Vymarus/34346-bikelight/KiCad/BikeLight/BikeLight.png

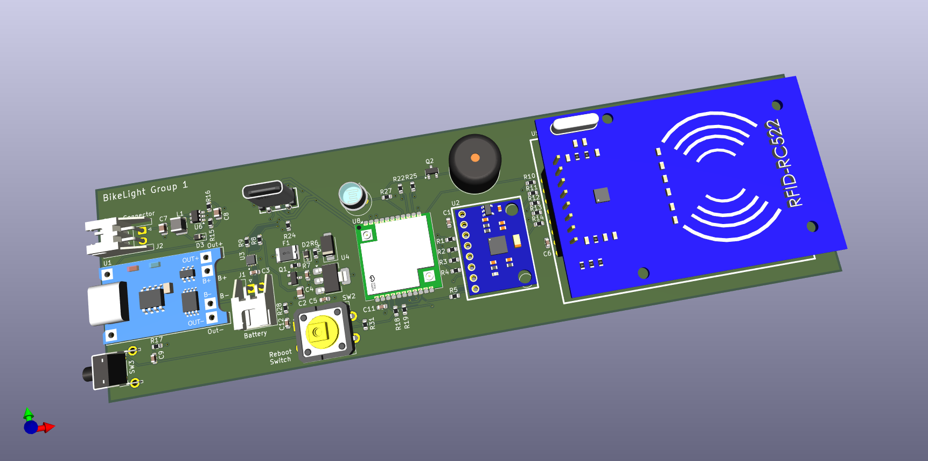
KiCad/BikeLight/BikeLight.png
