Vymarus/34346-bikelight/FreeCad/RFID_RC522-RFID.step

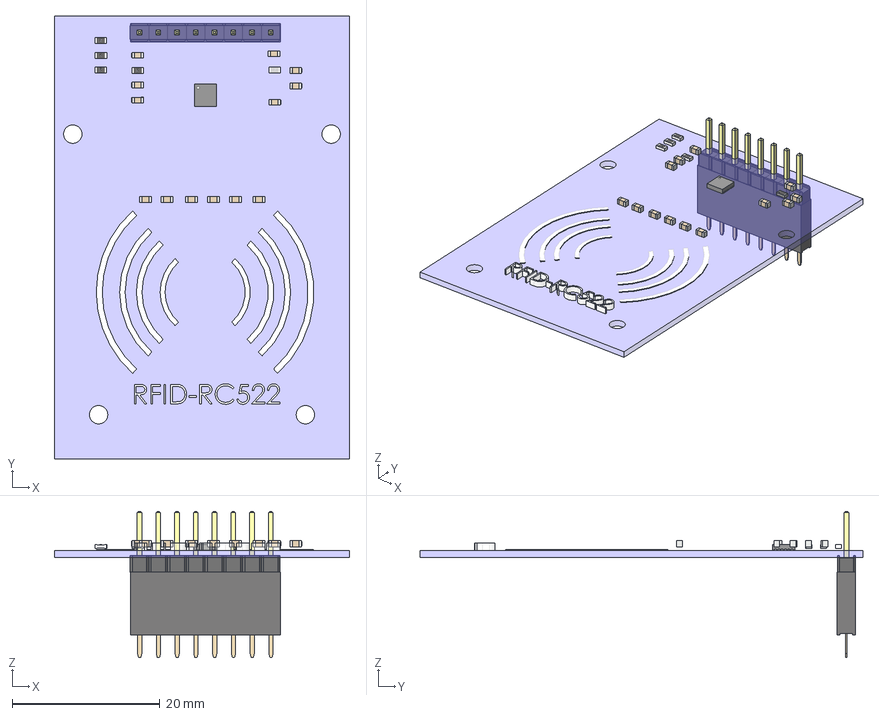
[picture p2: CAD file, 2025-05-14]
FreeCad/RFID_RC522-RFID.step
40.0 x 60.0 x 19.8 mm
User Library-S-PWSON-N12
User Library-S-PWSON-N013
User Library-S-PWSON-N014
User Library-S-PWSON-N015
User Library-S-PWSON-N016
User Library-S-PWSON-N017
User Library-S-PWSON-N018
User Library-S-PWSON-N019
User Library-S-PWSON-N020
User Library-S-PWSON-N021
User Library-S-PWSON-N022
User Library-S-PWSON-N023
User Library-S-PWSON-N024
User Library-S-PWSON-N025
User Library-Header_Male_8Pin
User Library-Header_Male_8Pin001
User Library-Header_Male_8Pin002
User Library-Header_Male_8Pin003
User Library-Header_Male_8Pin004
User Library-Header_Male_8Pin005
User Library-Header_Male_8Pin006
User Library-Header_Male_8Pin007
User Library-Header_Male_8Pin008
User Library-Header_Male_8Pin009
User Library-Header_Male_8Pin010
User Library-Header_Male_8Pin011
User Library-Header_Male_8Pin012
User Library-Header_Male_8Pin013
User Library-Header_Male_8Pin014
User Library-Header_Male_8Pin015
User Library-SMD Ceramic Capacitors_0603 (1608)_CH
User Library-SMD Ceramic Capacitors_0603 (1608)_CH001
User Library-SMD Ceramic Capacitors_0603 (1608)_CH002
User Library-SMD Ceramic Capacitors_0603 (1608)_CH004
User Library-SMD Ceramic Capacitors_0603 (1608)_CH005
User Library-SMD Ceramic Capacitors_0603 (1608)_CH006
User Library-SMD Ceramic Capacitors_0603 (1608)_CH008
User Library-SMD Ceramic Capacitors_0603 (1608)_CH009
User Library-SMD Ceramic Capacitors_0603 (1608)_CH010
User Library-SMD Ceramic Capacitors_0603 (1608)_CH012
User Library-SMD Ceramic Capacitors_0603 (1608)_CH013
User Library-SMD Ceramic Capacitors_0603 (1608)_CH014
User Library-SMD Ceramic Capacitors_0603 (1608)_CH016
User Library-SMD Ceramic Capacitors_0603 (1608)_CH017
User Library-SMD Ceramic Capacitors_0603 (1608)_CH018
User Library-SMD Ceramic Capacitors_0603 (1608)_CH020
User Library-SMD Ceramic Capacitors_0603 (1608)_CH021
User Library-SMD Ceramic Capacitors_0603 (1608)_CH022
User Library-SMD Ceramic Capacitors_0603 (1608)_CH024
User Library-SMD Ceramic Capacitors_0603 (1608)_CH025
User Library-SMD Ceramic Capacitors_0603 (1608)_CH026
User Library-SMD Ceramic Capacitors_0603 (1608)_CH028
User Library-SMD Ceramic Capacitors_0603 (1608)_CH029
User Library-SMD Ceramic Capacitors_0603 (1608)_CH030
User Library-SMD Ceramic Capacitors_0603 (1608)_CH032
User Library-SMD Ceramic Capacitors_0603 (1608)_CH033
User Library-SMD Ceramic Capacitors_0603 (1608)_CH034
User Library-SMD Ceramic Capacitors_0603 (1608)_CH036
User Library-SMD Ceramic Capacitors_0603 (1608)_CH037
User Library-SMD Ceramic Capacitors_0603 (1608)_CH038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
