Vymarus/34346-bikelight/KiCad/BikeLight/BikeLight3D/RFID_RC522.step

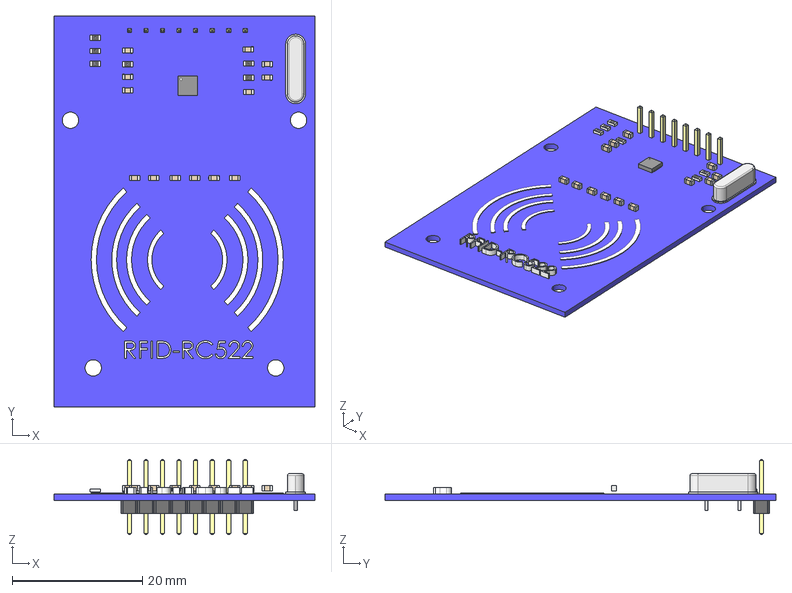
[picture p4: CAD file, 2025-04-30]
KiCad/BikeLight/BikeLight3D/RFID_RC522.step
40.0 x 60.0 x 11.5 mm
User Library-S-PWSON-N12
User Library-S-PWSON-N013
User Library-S-PWSON-N014
User Library-S-PWSON-N015
User Library-S-PWSON-N016
User Library-S-PWSON-N017
User Library-S-PWSON-N018
User Library-S-PWSON-N019
User Library-S-PWSON-N020
User Library-S-PWSON-N021
User Library-S-PWSON-N022
User Library-S-PWSON-N023
User Library-S-PWSON-N024
User Library-S-PWSON-N025
User Library-Header_Male_8Pin
User Library-Header_Male_8Pin001
User Library-Header_Male_8Pin002
User Library-Header_Male_8Pin003
User Library-Header_Male_8Pin004
User Library-Header_Male_8Pin005
User Library-Header_Male_8Pin006
User Library-Header_Male_8Pin007
User Library-Header_Male_8Pin008
User Library-Header_Male_8Pin009
User Library-Header_Male_8Pin010
User Library-Header_Male_8Pin011
User Library-Header_Male_8Pin012
User Library-Header_Male_8Pin013
User Library-Header_Male_8Pin014
User Library-Header_Male_8Pin015
User Library-SMD Ceramic Capacitors_0603 (1608)_CH x 13
User Library-SMD Ceramic Capacitors_0603 (1608)_CH001 x 13
User Library-SMD Ceramic Capacitors_0603 (1608)_CH002 x 13
