Vymarus/34346-bikelight/KiCad/BikeLight/BikeLight3D/PCB_TP_4056.stp

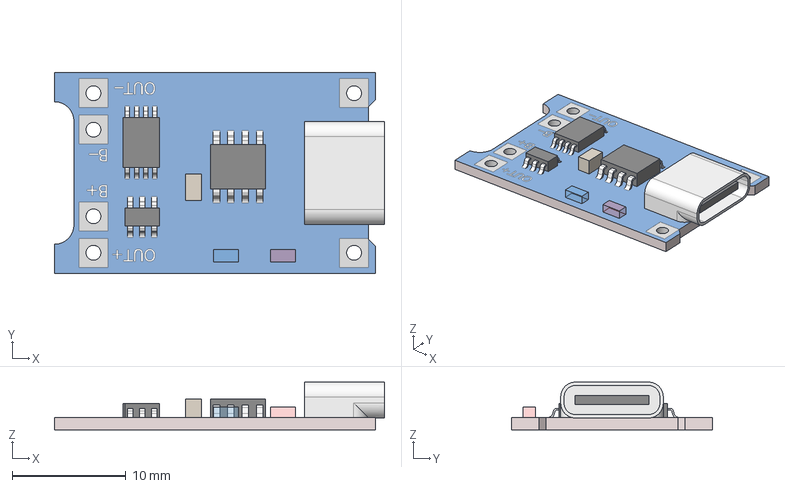
[picture p6: CAD file, 2025-04-24]
KiCad/BikeLight/BikeLight3D/PCB_TP_4056.stp
28.9 x 17.6 x 4.20 mm
