Vymarus/34346-bikelight/KiCad/BikeLight/BikeLight3D/GY-521.step

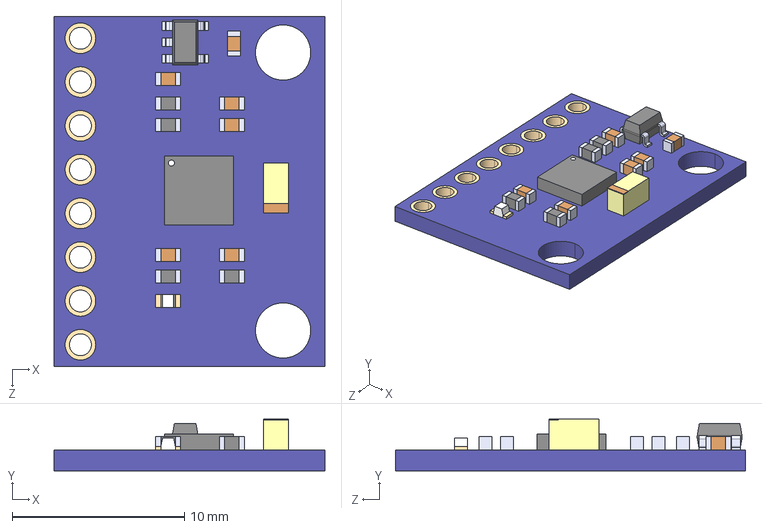
[picture p7: CAD file, 2025-04-24]
KiCad/BikeLight/BikeLight3D/GY-521.step
15.7 x 3.00 x 20.3 mm
