Vymarus/34346-bikelight/KiCad/BikeLight/BikeLight3D/MAX17048G_T10.step

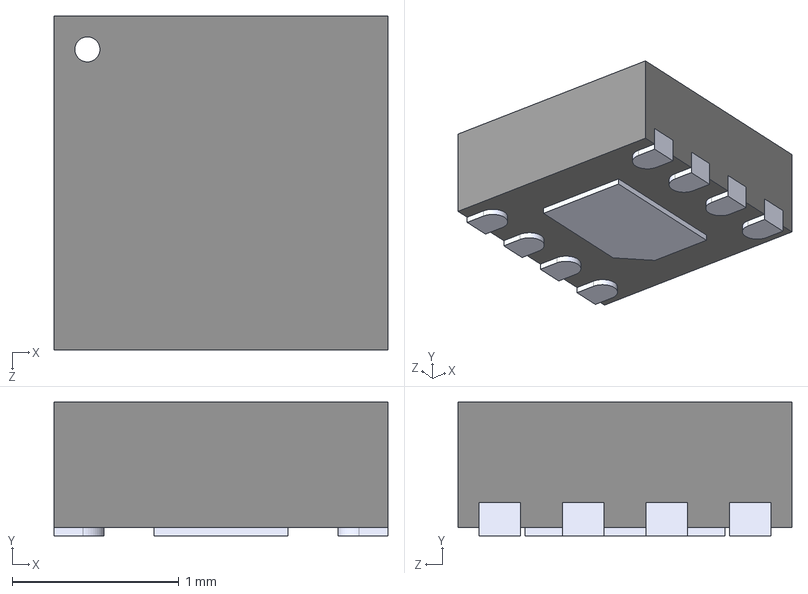
[picture p8: CAD file, 2025-04-24]
KiCad/BikeLight/BikeLight3D/MAX17048G_T10.step
2.00 x 0.8 x 2.00 mm
