Vymarus/34346-bikelight/(list of files, cad)

Other CAD files:
FreeCad/RFID_RC522.FCStd
