Vymarus/34346-bikelight/KiCad/BikeLight/BikeLight.kicad_pcb

## KiCad design KiCad/BikeLight/BikeLight.kicad_pcb (2025-05-24)

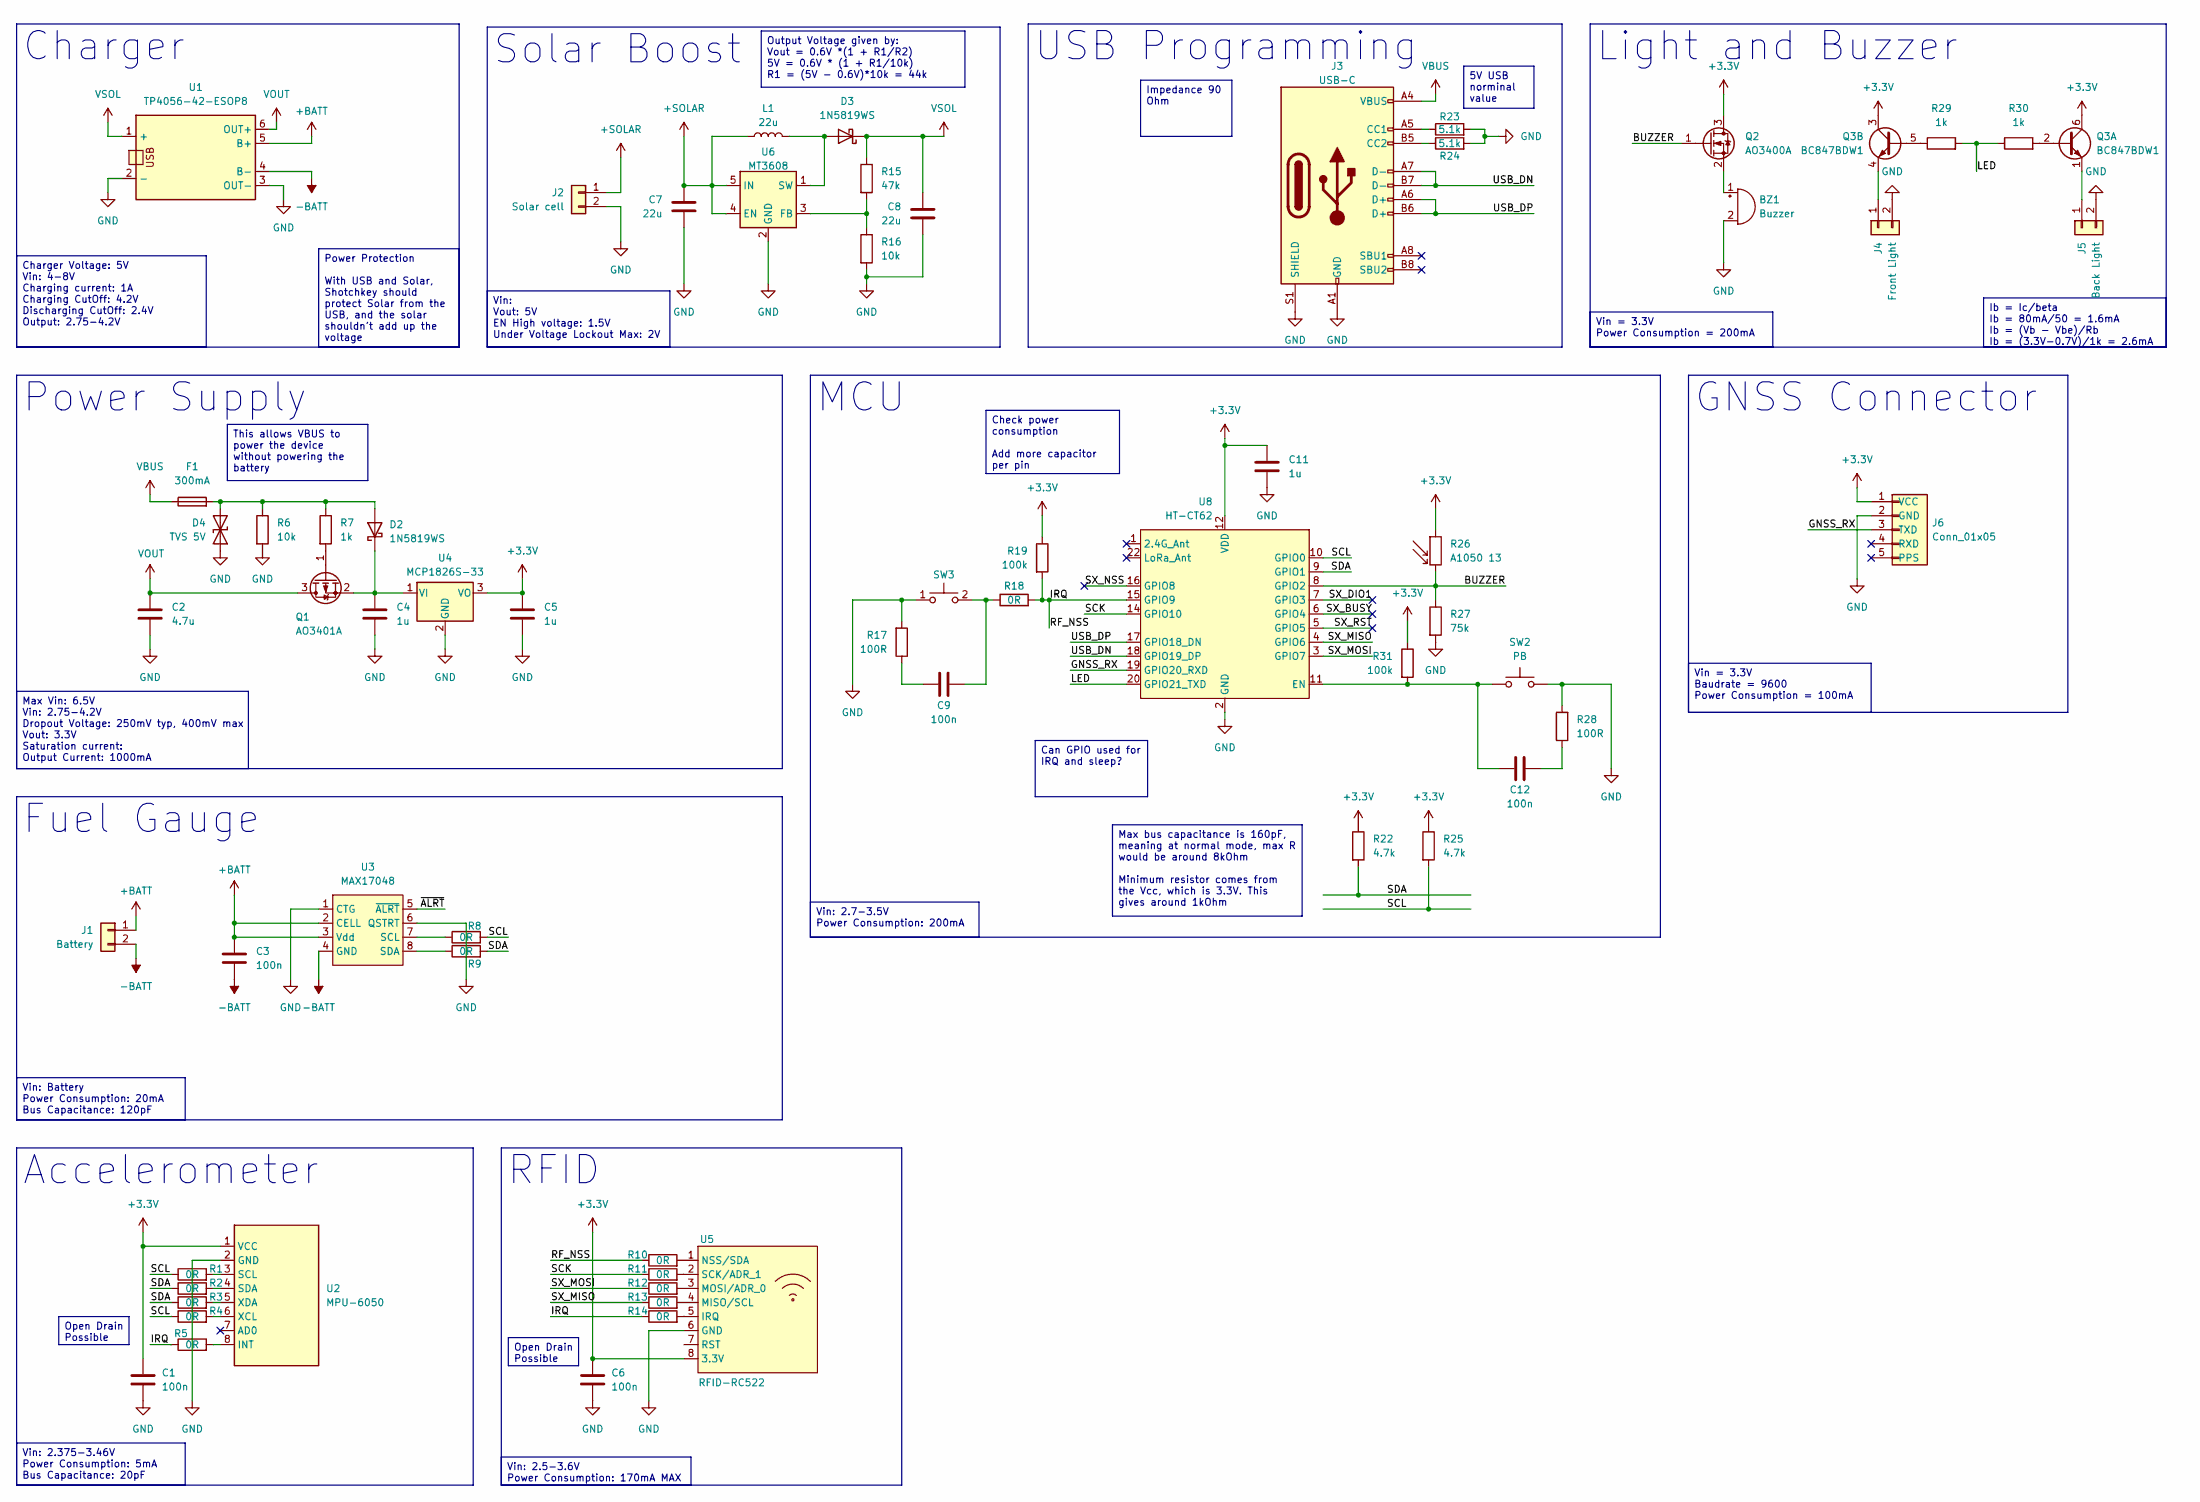
[picture p9: schematic BikeLight.kicad_sch, BeamBuddy]

Parts:
BZ1: TMB12A03; Buzzer_12x9.5RM7.6; MPN TMB12A03
C1, C3, C6, C9, C12: 100n_0603_TCC0603X7R104K500CT; C_0603_1608Metric; Tolerance 10%; Rating 50V; MPN TCC0603X7R104K500CT
C2: 4.7u_0805_CL21A475KAQNNNE; C_0805_2012Metric; Rating 25V; Tolerance 10%; MPN CL21A475KAQNNNE
C4: 1u_0603_CL10A105KA8NNNC; C_0603_1608Metric; MPN CL10A105KA8NNNC
C5, C11: 1u_0603_UMK107BJ105KA-T; C_0603_1608Metric; MPN UMK107BJ105KA-T
C7, C8: 22u_0805_CL21A226MAQNNNE; C_0805_2012Metric; Rating 10V; Tolerance 20%; MPN CL21A226MAQNNNE
D2, D3: 1N5819WS; D_SOD-323; MPN 1N5819WS
D4: SMAJ5.0CA/TR13_NONAME; D_SMA; MPN SMAJ5.0CA/TR13
F1: MF-MSMF010-2; Fuse_1812_4532Metric; MPN MF-MSMF010-2
J1, J2, J4, J5: Conn-01x02_P2.5mm_S2B-XH-A-BK(LF)(SN); JST_XH_S2B-XH-A_1x02_P2.50mm_Horizontal; MPN S2B-XH-A-BK(LF)(SN)
J3: GT-USB-7051A; USB-C-SMD_GT-USB-7051A; MPN GT-USB-7051A
J6: Conn_01x05; PinHeader_1x05_P2.54mm_Horizontal; LCSC C492413
L1: 22u_620mA_1210_CBC3225T220KR; L_1210_3225Metric; Rating 620mA; MPN CBC3225T220KR
Q1: AO3401A; SOT-23; MPN AO3401A
Q2: AO3400A; SOT-23; MPN AO3400A
Q3: BC847BDW1; SOT-363_SC-70-6
R1, R2, R3, R4, R5, R8, R9, R10, R11, R12, R13, R14, R18: 0R_0603_0603WAF0000T5E; R_0603_1608Metric; MPN 0603WAF0000T5E
R6, R16: 10k_0603_RC0603JR-0710KL; R_0603_1608Metric; Tolerance 1%; MPN RC0603JR-0710KL
R7, R29, R30: 1k_0603_RMC06031K1%N; R_0603_1608Metric; Tolerance 1%; MPN RMC06031K1%N
R15: 47k_0402_0402WGF1002TCE; R_0603_1608Metric; Tolerance 1%; MPN 0402WGF4702TCE
R17, R28: 100R_0603_RC0603FR-07100RL; R_0603_1608Metric; Tolerance 1%; MPN RC0603FR-07100RL
R19, R31: 100k_0603_RC0603FR-07100KL; R_0603_1608Metric; MPN RC0603FR-07100KL
R22, R25: 4.7k_0402_0402WGF4701TCE; R_0603_1608Metric; Tolerance 1%; MPN 0402WGF4701TCE
R23, R24: 5.1k_0603_0603WAF5101T5E; R_0603_1608Metric; Tolerance 1%; MPN 0603WAF5101T5E
R26: A1050 13; R_LDR_D6.4mm_P3.4mm_Vertical
R27: 75k_0603_RC0603FR-0775KL; R_0603_1608Metric; MPN RC0603FR-0775KL
SW2: SW_PB_B3F-4055; MPN B3F-4055
SW3: K2-1102AQ-H4CW-01; SW_Tactile_SPST_Angled_K2-1102AQ-H4CW-01; MPN K2-1102AQ-H4CW-01
U1: TP4056-42-ESOP8; TP4056-18650
U2: MPU-6050; GY-521_Angled
U3: MAX17048; SON50P200X200X80-9N
U4: MCP1826S-33; SOT-223-3_TabPin2
U5: RFID-RC522; RFID_RC522
U6: MT3608; SOT-23-6
U8: HT-CT62; Heltec_HT-CT62

Connections:
+3.3V: C1.1, C5.1, C6.1, C11.1, J6.1 (VCC), Q2.3 (D), Q3.3 (C2), Q3.6 (C1), R19.1, R22.1, R25.1, R26.1, R31.1, U2.1 (VCC), U4.3 (VO), U5.8 (3.3V), U8.12 (VDD)
+BATT: C3.1, J1.1, U1.5 (B+), U3.2 (CELL), U3.3 (Vdd)
+SOLAR: C7.1, J2.1, L1.1, U6.4 (EN), U6.5 (IN)
-BATT: C3.2, J1.2, U1.4 (B-), U3.4 (GND)
/BUZZER: Q2.1 (G), R26.2, R27.1, U8.8 (GPIO2)
/GNSS_RX: J6.3 (TXD), U8.19 (GPIO20_RXD)
/IRQ: R5.1, R10.1, R14.1, R18.2, R19.2, U8.15 (GPIO9)
/LED: R29.2, R30.1, U8.20 (GPIO21_TXD)
/SCK: R11.1, U8.14 (GPIO10)
/SCL: R1.1, R4.1, R8.2, R25.2, U8.10 (GPIO0)
/SDA: R2.1, R3.1, R9.2, R22.2, U8.9 (GPIO1)
/SX_BUSY: U8.6 (GPIO4)
/SX_DIO1: U8.7 (GPIO3)
/SX_MISO: R13.1, U8.4 (GPIO6)
/SX_MOSI: R12.1, U8.3 (GPIO7)
/SX_NSS: U8.16 (GPIO8)
/SX_RST: U8.5 (GPIO5)
/USB_DN: J3.A7 (D-), J3.B7 (D-), U8.18 (GPIO19_DP)
/USB_DP: J3.A6 (D+), J3.B6 (D+), U8.17 (GPIO18_DN)
/~ALRT: U3.5 (~ALRT)
GND: BZ1.2 (-), C1.2, C2.2, C4.2, C5.2, C6.2, C7.2, C8.2, C11.2, D4.1 (A1), J2.2, J3.A1 (GND), J3.A12 (GND), J3.B1 (GND), J3.B12 (GND), J3.S1 (SHIELD), J4.2, J5.2, J6.2 (GND), R6.2, R16.2, R17.2, R23.2, R24.2, R27.2, R28.2, SW2.2, SW3.1, U1.2 (-), U1.3 (OUT-), U2.2 (GND), U3.1 (CTG), U3.6 (QSTRT), U4.2 (GND), U5.6 (GND), U6.2 (GND), U8.2 (GND), U8.13 (GND), U8.21 (GND)
unnamed: BZ1.1 (+), Q2.2 (S)
unnamed: C9.1, R17.1
unnamed: C9.2, R18.1, SW3.2
unnamed: C12.1, R28.1
unnamed: D2.2 (A), D4.2 (A2), F1.2, R6.1, R7.1
unnamed: C4.1, D2.1 (K), Q1.2 (S), U4.1 (VI)
unnamed: D3.2 (A), L1.2, U6.1 (SW)
unnamed: J3.A5 (CC1), R23.1
unnamed: J3.B5 (CC2), R24.1
unnamed: J4.1, Q3.4 (E2)
unnamed: J5.1, Q3.1 (E1)
unnamed: Q1.1 (G), R7.2
unnamed: Q3.2 (B1), R30.2
unnamed: Q3.5 (B2), R29.1
unnamed: R5.2, U2.8 (INT)
unnamed: R1.2, U2.3 (SCL)
unnamed: R2.2, U2.4 (SDA)
unnamed: R4.2, U2.6 (XCL)
unnamed: R3.2, U2.5 (XDA)
unnamed: R8.1, U3.7 (SCL)
unnamed: R9.1, U3.8 (SDA)
unnamed: R14.2, U5.5 (IRQ)
unnamed: R13.2, U5.4 (MISO/SCL)
unnamed: R12.2, U5.3 (MOSI/ADR_0)
unnamed: R10.2, U5.1 (NSS/SDA)
unnamed: R11.2, U5.2 (SCK/ADR_1)
unnamed: R15.2, R16.1, U6.3 (FB)
unnamed: C12.2, R31.2, SW2.1, U8.11 (EN)
VBUS: F1.1, J3.A4 (VBUS), J3.A9 (VBUS), J3.B4 (VBUS), J3.B9 (VBUS)
VOUT: C2.1, Q1.3 (D), U1.6 (OUT+)
VSOL: C8.1, D3.1 (K), R15.1, U1.1 (+)

Notes on the sheet:
Charger
Vin: 2.5-3.6V Power Consumption: 170mA MAX
Vin: Battery Power Consumption: 20mA Bus Capacitance: 120pF
Open Drain Possible
Vin = 3.3V Baudrate = 9600 Power Consumption = 100mA
Power Supply
Vin: Vout: 5V EN High voltage: 1.5V Under Voltage Lockout Max: 2V
Output Voltage given by: Vout = 0.6V *(1 + R1/R2) 5V = 0.6V * (1 + R1/10k) R1 = (5V - 0.6V)*10k = 44k
GNSS Connector
This allows VBUS to power the device without powering the battery
Ib = Ic/beta Ib = 80mA/50 = 1.6mA Ib = (Vb - Vbe)/Rb Ib = (3.3V-0.7V)/1k = 2.6mA
USB Programming
Impedance 90 Ohm
MCU
Power Protection With USB and Solar, Shotchkey should protect Solar from the USB, and the solar shouldn't add up the voltage
5V USB norminal value
Light and Buzzer
Max Vin: 6.5V Vin: 2.75-4.2V Dropout Voltage: 250mV typ, 400mV max Vout: 3.3V Saturation current: Output Current: 1000mA
Vin: 2.7-3.5V Power Consumption: 200mA
Check power consumption Add more capacitor per pin
Vin = 3.3V Power Consumption = 200mA
Solar Boost
Can GPIO used for IRQ and sleep?
Vin: 2.375-3.46V Power Consumption: 5mA Bus Capacitance: 20pF
RFID
Charger Voltage: 5V Vin: 4-8V Charging current: 1A Charging CutOff: 4.2V Discharging CutOff: 2.4V Output: 2.75-4.2V
Max bus capacitance is 160pF, meaning at normal mode, max R would be around 8kOhm Minimum resistor comes from the Vcc, which is 3.3V. This gives around 1kOhm
Accelerometer
Fuel Gauge

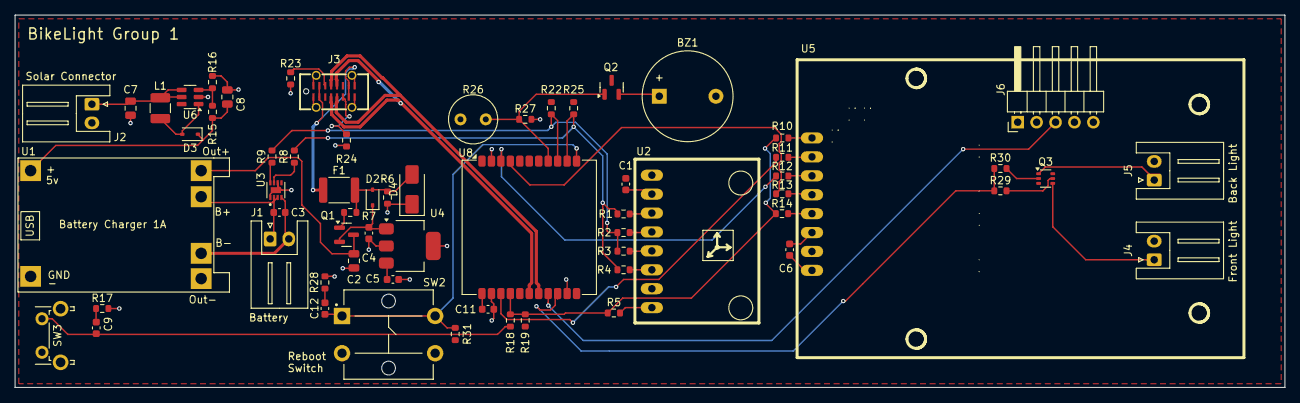
[picture p10: board BikeLight.kicad_pcb from above]

Board: 2 copper layers, 170.5 x 50.0 mm, 64 parts (0 on the bottom side), 47 nets.
