Vymarus/34346-bikelight/(commit log)

2025-04-21 KiCad Project and Accelerometer class
    [BikeLight.kicad_pcb, BikeLight.kicad_sch]
2025-04-23 Updated schematic, added datasheet
    [BikeLight.kicad_sch]
2025-04-24 started with pcb
    [BikeLight.kicad_pcb, BikeLight.kicad_sch, GY-521.step, MAX17048G_T10.step, PCB_TP_4056.stp]
2025-04-24 More Schematic
    [BikeLight.kicad_sch]
2025-04-25 Small adjustments to the RFID
    [BikeLight.kicad_sch]
2025-04-25 Changed RFID to use I2C
    [BikeLight.kicad_sch]
2025-04-28 Added power protection, annotated
    [BikeLight.kicad_pcb, BikeLight.kicad_sch]
2025-04-30 Finished most of the PCB
    [BikeLight.kicad_pcb, BikeLight.kicad_sch, BikeLight.step, RFID_RC522-RFID.step, RFID_RC522.FCStd, RFID_RC522.kicad_pcb, RFID_RC522.step]
2025-05-01 Added Busser and LED controller
    [BikeLight.kicad_pcb, BikeLight.kicad_sch]
2025-05-08 Comenting files
    [Accelerometer.kicad_sch, BikeLight.kicad_pcb, BikeLight.kicad_sch, Charger.kicad_sch, FuelGauge.kicad_sch, GPIO-extender.kicad_sch, Light.kicad_sch, MCU.kicad_sch]
2025-05-08 Changing GPIO pins
    [BikeLight.kicad_sch]
2025-05-14 Gerber generation
    [BikeLight-B_Cu.gbr, BikeLight-B_Mask.gbr, BikeLight-B_Paste.gbr, BikeLight-B_Silkscreen.gbr, BikeLight-Edge_Cuts.gbr, BikeLight-F_Cu.gbr, BikeLight-F_Mask.gbr, BikeLight-F_Paste.gbr]
2025-05-21 Changing pins
    [BikeLight.kicad_sch]
2025-05-23 Small updates to pins
    [BikeLight.kicad_sch]
2025-05-23 Changed and updated 3D models of devices
    [BikeLight.kicad_pcb, BikeLight.kicad_sch]
2025-05-23 changed sheet size
    [BikeLight.kicad_pcb]
2025-05-23 Cleanup and created new fabrication files
    [Accelerometer.kicad_sch, BikeLight.csv, BikeLight.kicad_pcb, Charger.kicad_sch, FuelGauge.kicad_sch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]
2025-05-24 Updating sch and pcb
    [BikeLight.kicad_pcb, BikeLight.kicad_sch]
